lw1414/LoRa---IOT/SX1262 Reference FIles/SX1262MB2CAS_915MHz_e499v01b_prod_folder/SX1262MB2CAS_915MHz_e499v01b_BOM.xlsx

Sheet: SX1262MB2CAS
 |  |  | SX1262MB2CAS mbed shield - 4-Layers 915MHz BOM |  |  | BOM # V1a
 |  |  |  |  |  | SCH # e499v01b
 |  |  | 2019-05-21 | EMr | Version e499v01b | PCB # e499v01b
RefDes | MPN | Geom | Value | Qty | Description | Manufacturer
U1 | SX1262IMLTRT | VQFN24 4x4mm | SX1262 | 1 | 150MHz to 960MHz Low Power Long Range Transceiver | Semtech
U2 | PE4259 | SC70-6 | PE4259 | 1 | SPDT High Power UltraCMOS 10 MHz - 3.0 GHz RF Switch | Peregrine
Resistors
R1 | CRCW06030000Z0EAHP | 0603 | 0R | 1 | Thick Film Resistor ±1%, 1/4W | Vishay/Dale
R2 | CRCW06030000Z0EAHP | 0603 | 0R | 1 | Thick Film Resistor ±1%, 1/4W | Vishay/Dale
R3 | CRCW0402100RFKED | 0402 | 100R | 1 | Thick Film Resistor ±1%, 1/16W | Vishay/Dale
R4 | CRCW0402100RFKED | 0402 | 100R | 1 | Thick Film Resistor ±1%, 1/16W | Vishay/Dale
R5 | CRCW04023K30JNED | 0402 | 3.3k | 1 | Thick Film Resistor ±1%, 1/16W | Vishay/Dale
R6 | CRCW04023K30JNED | 0402 | 3.3k | 1 | Thick Film Resistor ±1%, 1/16W | Vishay/Dale
R915 | CRCW04020000Z0ED | 0402 | 0R | 1 | Thick Film Resistor ±1%, 1/16W | Vishay/Dale
SX1262 | CRCW040210K0FKED | 0402 | 10k | 1 | Thick Film Resistor ±1%, 1/16W | Vishay/Dale
FR1 | CRCW040210K0FKED | 0402 | 10k | 1 | Thick Film Resistor ±1%, 1/16W | Vishay/Dale
XTAL | CRCW04020000Z0ED | 0402 | 0R | 1 | Thick Film Resistor ±1%, 1/16W | Vishay/Dale
Capacitors
C1 | GRM155R71C473KA01J | 0402 | 47nF | 1 | Multilayer ceramic capacitors X7R ±1%, 16V | Murata
C2 | GRM1555C1H470JZ01D | 0402 | 47pF | 1 | Multilayer ceramic capacitors C0G ±5%, 50V | Murata
C4 | GRM1555C1H3R0BA01D | 0402 | 3.0pF | 1 | Multilayer ceramic capacitors C0G ±0.1pF, 50V | Murata
C5 | GRM1555C1H5R6CA01D | 0402 | 5.6pF | 1 | Multilayer ceramic capacitors C0G ±0.25pF, 50V | Murata
C6 | GRM1555C1H390JA01D | 0402 | 39pF | 1 | Multilayer ceramic capacitors C0G ±5%, 50V | Murata
C7 | GRM1555C1H1R8BA01D | 0402 | 1.8pF | 1 | Multilayer ceramic capacitors C0G ±0.1pF, 50V | Murata
C8 | GRM1555C1H390JA01D | 0402 | 39pF | 1 | Multilayer ceramic capacitors C0G ±5%, 50V | Murata
C9 | GRM1555C1H3R3BA01D | 0402 | 3.3pF | 1 | Multilayer ceramic capacitors C0G ±0.1pF, 50V | Murata
C10 | GRM1555C1H3R3BA01D | 0402 | 3.3pF | 1 | Multilayer ceramic capacitors C0G ±0.1pF, 50V | Murata
C11 | GRM1555C1H2R4BA01D | 0402 | 2.4pF | 1 | Multilayer ceramic capacitors C0G ±0.1pF, 50V | Murata
C12 | GRM1555C1H1R8BA01D | 0402 | 1.8pF | 1 | Multilayer ceramic capacitors C0G ±0.1pF, 50V | Murata
C14 | GRM155R61A102KA01D | 0402 | 1nF | 1 | Multilayer ceramic capacitors X5R ±10%, 10V | Murata
C15 | GRM155R61A102KA01D | 0402 | 1nF | 1 | Multilayer ceramic capacitors X5R ±10%, 10V | Murata
C16 | GRM155R61E105KA12D | 0402 | 1uF | 1 | Multilayer ceramic capacitors X5R ±10%, 10V | Murata
C17 | GRM155R61A474KE15D | 0402 | 470nF | 1 | Multilayer ceramic capacitors X5R ±10%, 10V | Murata
C18 | GRM155R71C104KA88D | 0402 | 100nF | 1 | Multilayer ceramic capacitors X7R ±10%, 16V | Murata
C20 | GRM188R61A105KA61D | 0603 | 1uF | 1 | Multilayer ceramic capacitors X5R ±10%, 10V | Murata
C21 | GRM188R61A105KA61D | 0603 | 1uF | 1 | Multilayer ceramic capacitors X5R ±10%, 10V | Murata
C22 | GRM21BR61C106KE15K | 0805 | 10uF | 1 | Multilayer ceramic capacitors X5R ±10%, 16V | Murata
C23 | GRM155R71C104KA88D | 0402 | 100nF | 1 | Multilayer ceramic capacitors X7R ±10%, 16V | Murata
Inductors & Ferrites
L1 | LQW15AN47NJ00D | 0402 | 47nH | 1 | Wirewound Inductor ±5% | Murata
L2 | CRCW04020000Z0ED | 0402 | 0R | 1 | Thick Film Resistor ±1%, 1/16W | Vishay/Dale
L3 | LQW15AN2N5C00D | 0402 | 2.5nH | 1 | Wirewound Inductor ±0.2nH | Murata
L4 | LQW15AN4N7C00D | 0402 | 4.7nH | 1 | Wirewound Inductor ±0.2nH | Murata
L5 | LQW15AN9N1H00D | 0402 | 9.1nH | 1 | Wirewound Inductor ±3% | Murata
L6 | LQW15AN15NH00D | 0402 | 15nH | 1 | Wirewound Inductor ±3% | Murata
L7 | MLZ2012M150W | 0805 | 15uH | 1 | MLZ2012 Multilayer Shielded Inductor ±5% | TDK
Crystal & TCXO
Q1 | EXS00A-CS06465 | NX2016SA 2.0x1.6mm | 32.000MHz | 1 | Crystal unit NDK; Tol. ±10ppm, Cload=10pF, G-Senstivity=2ppb/G max | NDK
or | FTR5123-A0 | QESM09 2.0x1.6mm | 32.000MHz | - | Crystal unit Rakon; Tol. ±10ppm, Cload=10pF, G-Senstivity=2ppb/G max | Rakon
Connectors and others (or P/N equivalent)
ANT | 142-0701-841 | SMA End Launch | 50 Ohms | 1 | SMA End launch jack receptacle for PCB mount | Cinch Connectivity Sol Johnson
J1 | 68000-108HLF | Header 1x8 | 8 pins | 1 | 8 Pins - Through hole single row male connector, Bottom side | FCI
J2 | 68000-110HLF | Header 1x10 | 10 pins | 1 | 10 Pins - Through hole single row male connector, Bottom side | FCI
J3 | 68000-108HLF | Header 1x8 | 8 pins | 1 | 8 Pins - Through hole single row male connector, Bottom side | FCI
J4 | 68000-106HLF | Header 1x6 | 6 pins | 1 | 6 Pins - Through hole single row male connector, Bottom side | FCI
ANA_A5_A6 | 1125S-4P | 4-pin - Grove | 4 pins | 0 | 2mm pitch - Grove universal 4-pin connector for sensor (SKU: 320110033), Top side | Shenzhen NS-Tech
DIO_D9_D10 | 1125S-4P | 4-pin - Grove | 4 pins | 0 | 2mm pitch - Grove universal 4-pin connector for sensor (SKU: 320110033), Top side | Shenzhen NS-Tech
I2C | 1125S-4P | 4-pin - Grove | 4 pins | 0 | 2mm pitch - Grove universal 4-pin connector for sensor (SKU: 320110033), Top side | Shenzhen NS-Tech
Additional or optional components
- | BMI-S-209-F | Shield | - | 0 | Standard Surface Mount Shield in two parts with BMI-S-209-C cover (optional) | Laird Technologies
Remark: components not listed in the BOM or 0 quantity, are not populated on the module.

Sheet: Release
 |  | SX1262MB2CAS mbed shield - 2-Layers 915MHz BOM |  |  |  | BOM # V1a
 |  |  |  |  |  | SCH # e499v01b
 |  | 2019-05-21 | Emr | Version e499v01b |  | PCB # e499v01b
Release histroy
Version | Change notes |  |  |  | By
pcb_e499v01a | Mbed shield based on pcb_e428v03a Reference design - 915MHz version |  |  |  | EMr
pcb_e499v01b | Modified SMA Ground plane new ANT connector and cosmetic |  |  |  | EMr
 | Updated obsolete P/N for large capacitor values (>1.0uF) |  |  |  | EMr
