lw1414/LoRa---IOT/SX1262 Reference FIles/SX1262MB2CAS_915MHz_e499v01b_prod_folder/SX1262MB2xAS_e499v01b_sch_layout.pdf

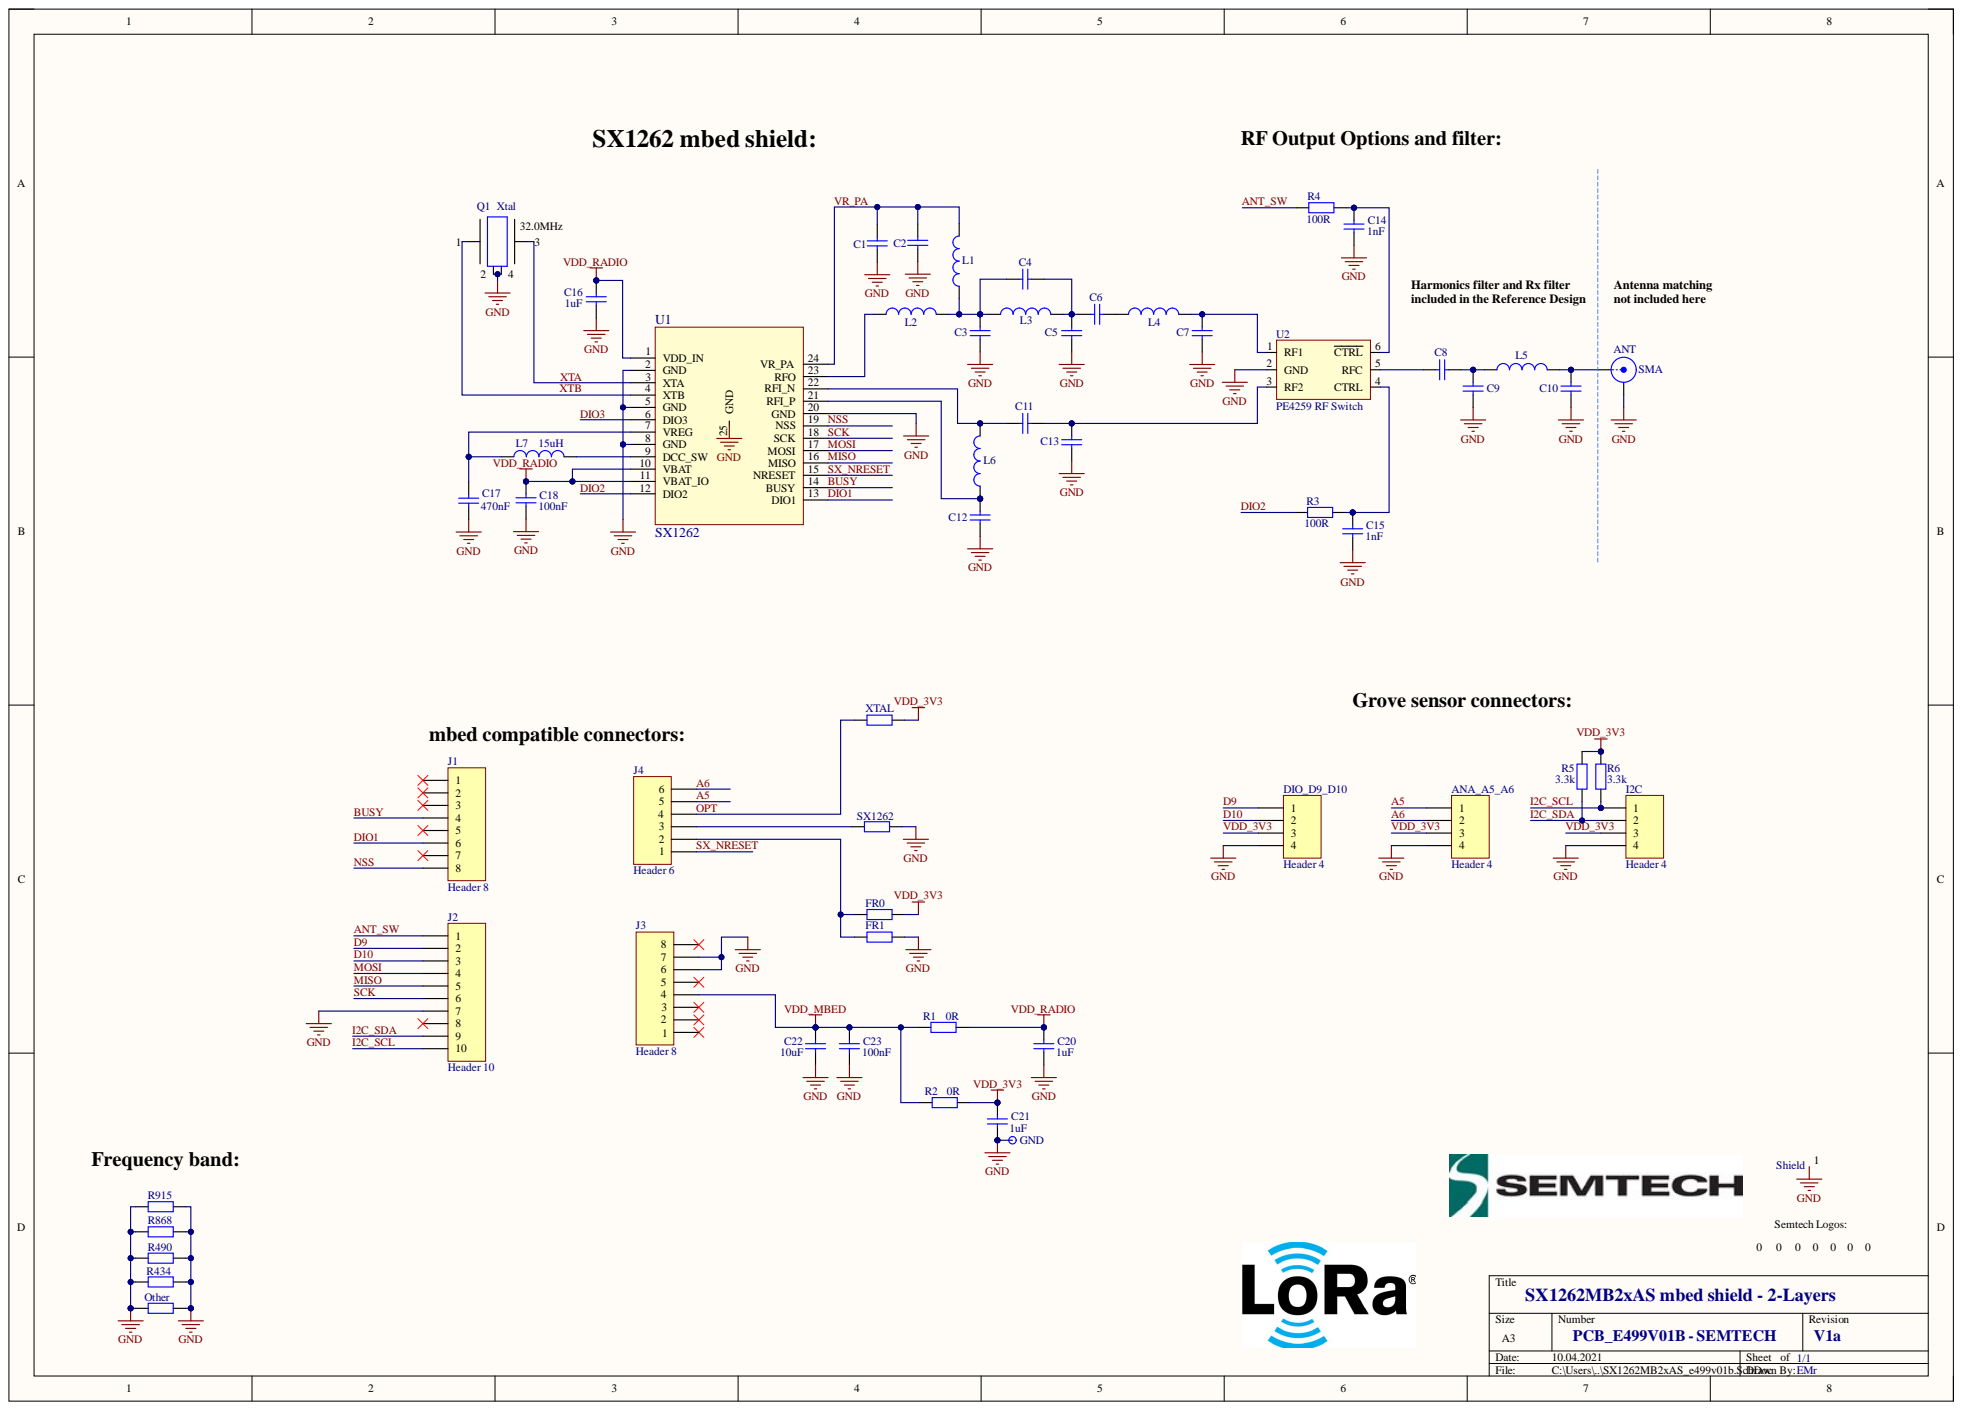
[picture p1: page 1]

RF Output Options and filter:

Harmonics filter and Rx filter
included in the Reference Design

DCC_SW 9 GND | MOSI GND MISO

VDD_RADIO | VBAT 10 | SX_NRESET

VBAT_IO 11 | BUSY

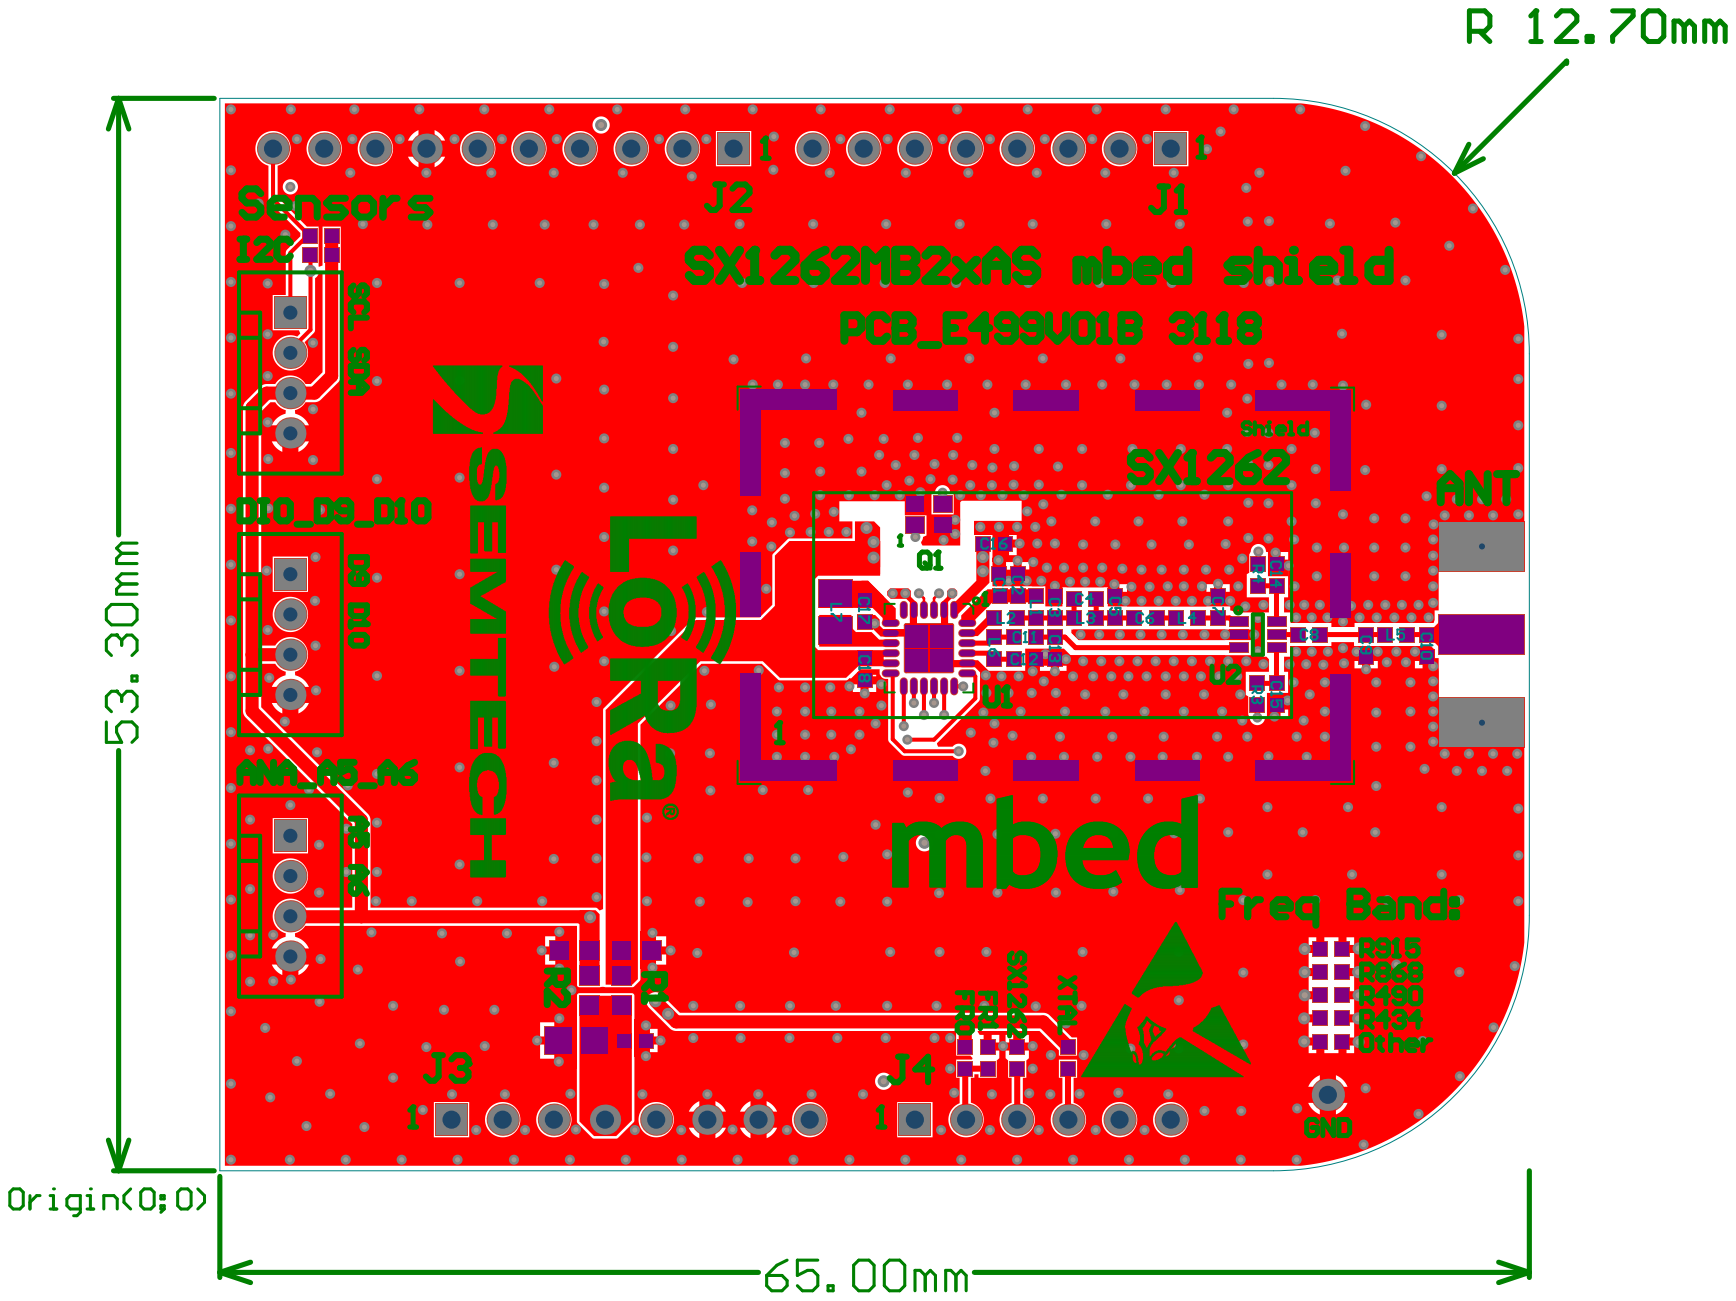
[picture p2: page 2]

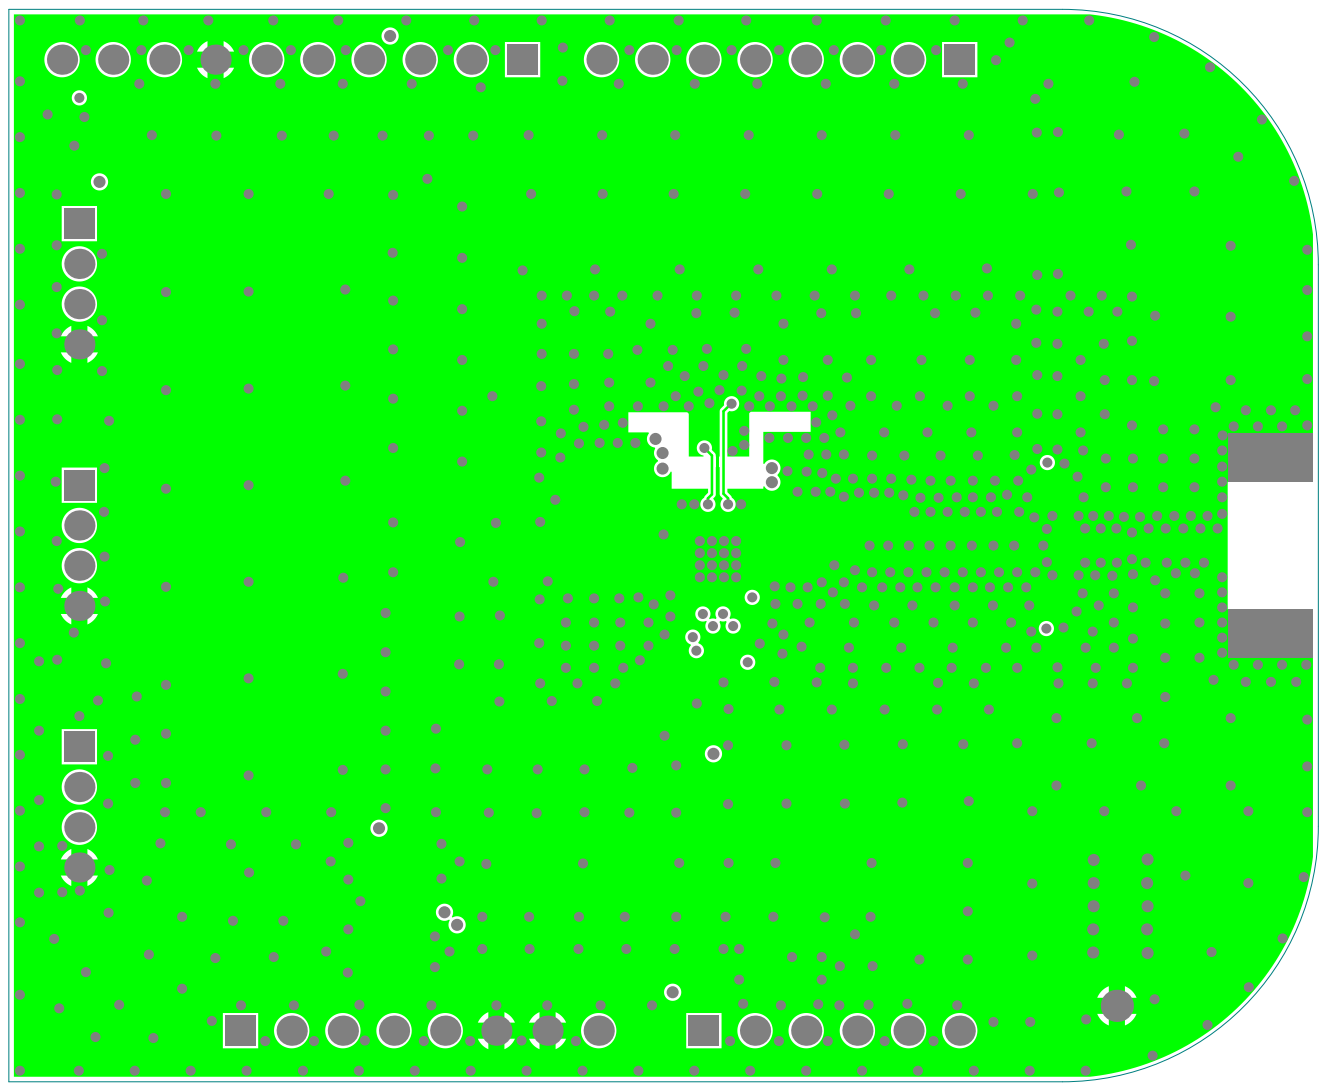
[picture p3: page 3]

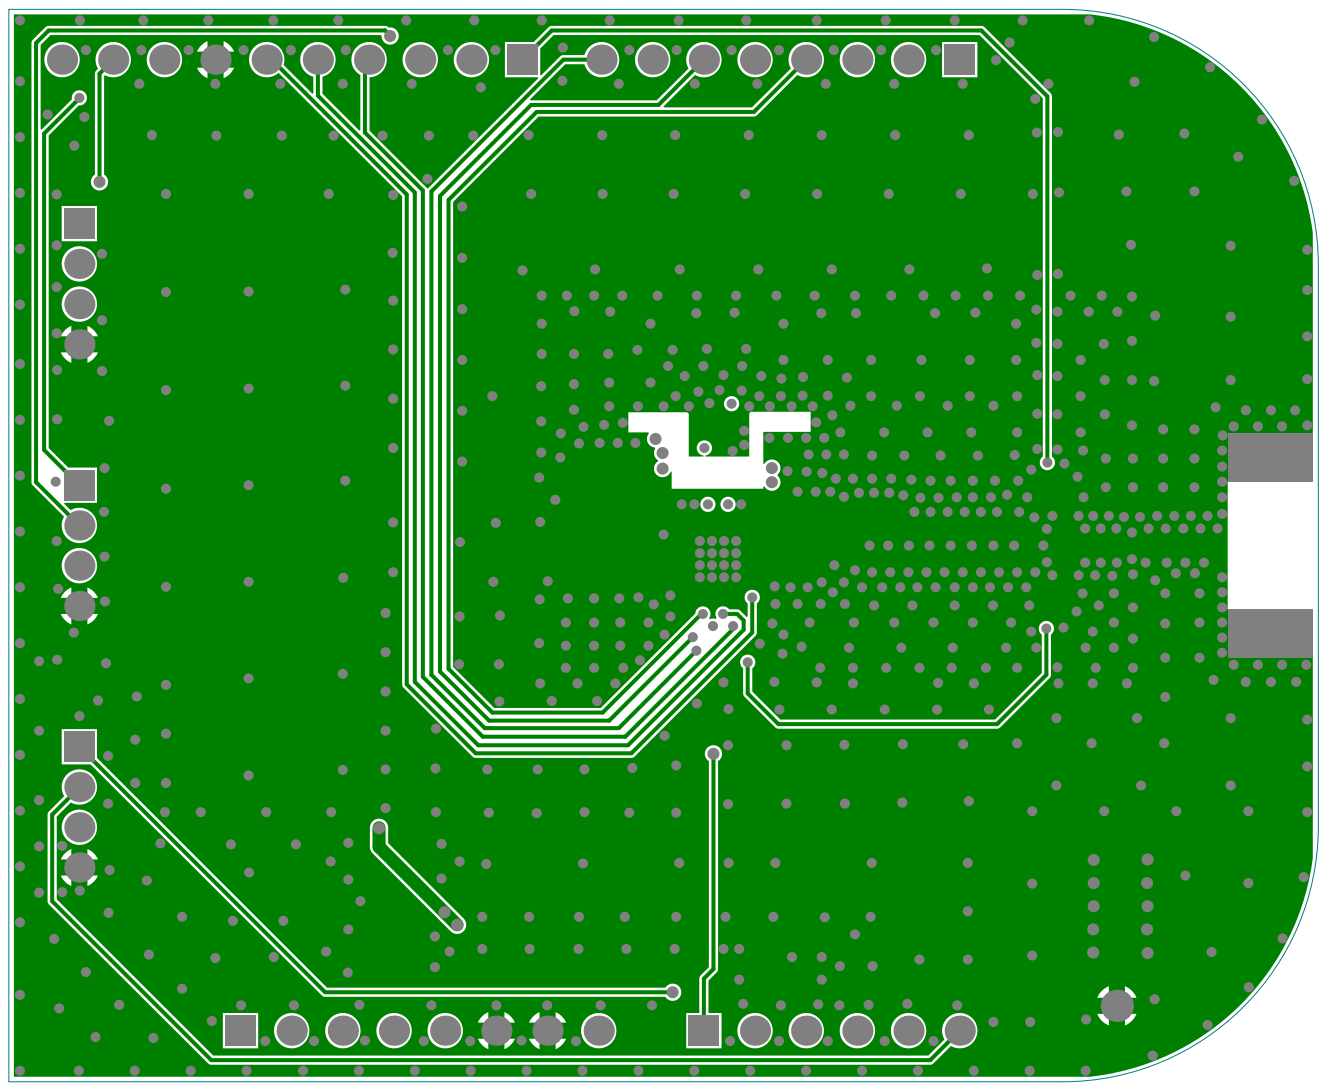
[picture p4: page 4]

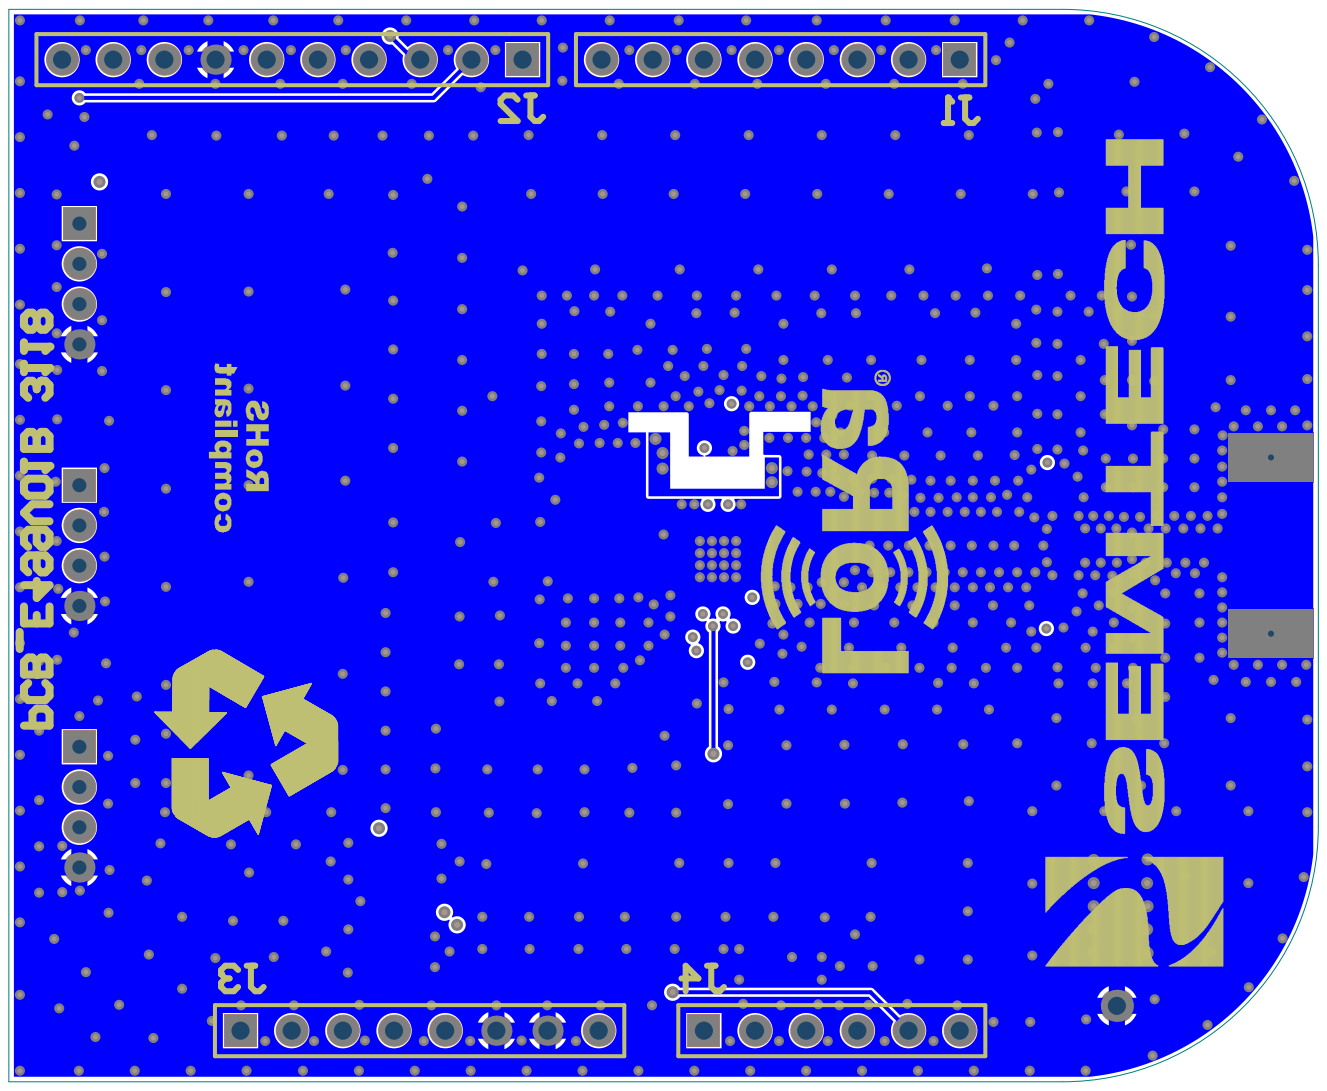
[picture p5: page 5]
