lw1414/LoRa---IOT/(list of files, drawings)

Other design files:
SX1262 Reference FIles/SX1262MB2xAS_e499v01b_PCB_Altium_Package/SX1262MB2xAS_e499v01b.PcbDoc
SX1262 Reference FIles/SX1262MB2xAS_e499v01b_PCB_Altium_Package/SX1262MB2xAS_e499v01b.PcbLib
SX1262 Reference FIles/SX1262MB2xAS_e499v01b_PCB_Altium_Package/SX1262MB2xAS_e499v01b.PrjPCB
SX1262 Reference FIles/SX1262MB2xAS_e499v01b_PCB_Altium_Package/SX1262MB2xAS_e499v01b.SchDoc
SX1262 Reference FIles/SX1262MB2xAS_e499v01b_PCB_Altium_Package/SX1262MB2xAS_e499v01b.SchLib
