lw1414/LoRa---IOT/SX1262_LoRa_Module/SX1262_LoRa_Module.kicad_pcb

## KiCad design SX1262_LoRa_Module/SX1262_LoRa_Module.kicad_pcb (2026-10-25)

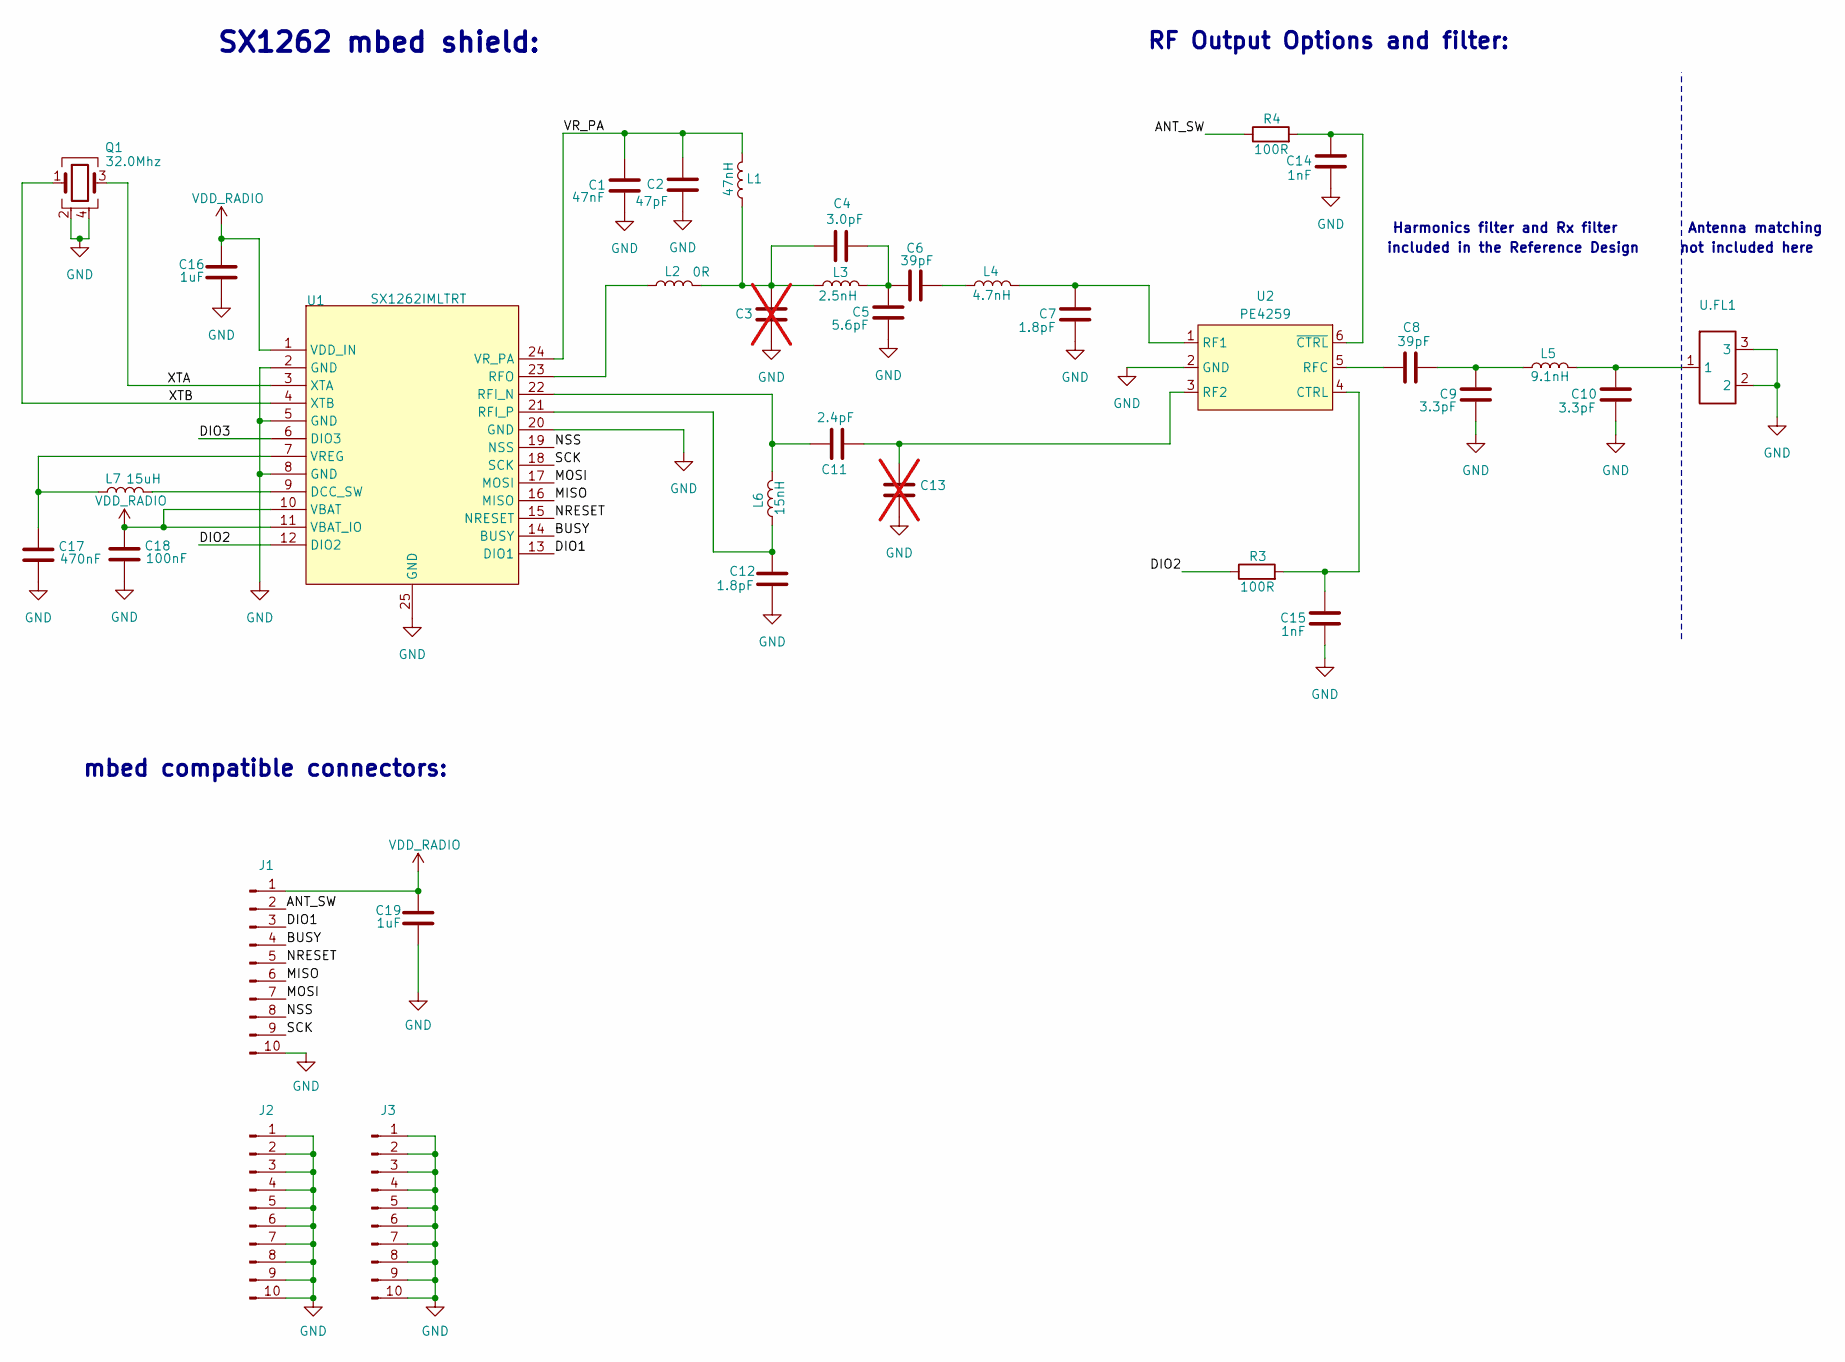
[picture p6: schematic SX1262_LoRa_Module.kicad_sch]

Parts:
C1: 47nF; C_0402_1005Metric; LCSC C307434
C2: 47pF; C_0402_1005Metric; LCSC C76970
C3, C13: C_0402_1005Metric; not fitted
C4: 3.0pF; C_0402_1005Metric; LCSC C88891
C5: 5.6pF; C_0402_1005Metric; LCSC C161329
C6, C8: 39pF; C_0402_1005Metric; LCSC C1563
C7, C12: 1.8pF; C_0402_1005Metric; LCSC C1553
C9, C10: 3.3pF; C_0402_1005Metric; LCSC C76906
C11: 2.4pF; C_0402_1005Metric; LCSC C48346
C14, C15: 1nF; C_0402_1005Metric; LCSC C189467
C16: 1uF; C_0402_1005Metric; LCSC C14445
C17: 470nF; C_0402_1005Metric; LCSC C92361
C18: 100nF; C_0402_1005Metric; LCSC C1525
C19: 1uF; C_0603_1608Metric; LCSC C53282223
J1, J2, J3: Conn_01x10_Pin; PinHeader_1x10_P2.54mm_Vertical
L1: 47nH; L_0402_1005Metric; LCSC C192855
L2: 0R; L_0402_1005Metric; LCSC C106231
L3: 2.5nH; L_0402_1005Metric; LCSC C703121
L4: 4.7nH; L_0402_1005Metric; LCSC C98064
L5: 9.1nH; L_0402_1005Metric; LCSC C6652904
L6: 15nH; L_0402_1005Metric; LCSC C91621
L7: 15uH; L0805; LCSC C383402
Q1: 32.0Mhz; CRYSTAL-SMD_4P-L2.0-W1.6-BL; LCSC C1986260
R3, R4: 100R; R_0402_1005Metric; LCSC C106232
U1: SX1262IMLTRT; QFN-24_L4.0-W4.0-P0.50-BL-EP2.6; LCSC C191341
U2: PE4259; SC-70-6_L2.2-W1.3-P0.65-LS2.1-BL; LCSC C470892
U.FL1: IPEX-SMD_3P-L2.6-W2.6-LS3.0; LCSC C22418213

Connections:
/ANT_SW: J1.2, R4.1
/BUSY: J1.4, U1.14 (BUSY)
/DIO1: J1.3, U1.13 (DIO1)
/DIO2: R3.1, U1.12 (DIO2)
/DIO3: U1.6 (DIO3)
/MISO: J1.6, U1.16 (MISO)
/MOSI: J1.7, U1.17 (MOSI)
/NRESET: J1.5, U1.15 (NRESET)
/NSS: J1.8, U1.19 (NSS)
/SCK: J1.9, U1.18 (SCK)
/VR_PA: C1.2, C2.2, L1.2, U1.24 (VR_PA)
/XTA: Q1.3, U1.3 (XTA)
/XTB: Q1.1, U1.4 (XTB)
GND: C1.1, C2.1, C3.1, C5.1, C7.1, C9.1, C10.1, C12.2, C13.1, C14.1, C15.1, C16.2, C17.2, C18.2, C19.2, J1.10, J2.1, J2.2, J2.3, J2.4, J2.5, J2.6, J2.7, J2.8, J2.9, J2.10, J3.1, J3.2, J3.3, J3.4, J3.5, J3.6, J3.7, J3.8, J3.9, J3.10, Q1.2, Q1.4, U1.2 (GND), U1.5 (GND), U1.8 (GND), U1.20 (GND), U1.25 (GND), U2.2 (GND), U.FL1.2, U.FL1.3; also elsewhere on the board
unnamed: C3.2, C4.2, L1.1, L2.2, L3.1
unnamed: C4.1, C5.2, C6.2, L3.2
unnamed: C6.1, L4.1
unnamed: C8.1, C9.2, L5.1
unnamed: C10.2, L5.2, U.FL1.1
unnamed: L7.2, U1.9 (DCC_SW)
unnamed: C11.1, L6.2, U1.22 (RFI_N)
unnamed: C12.1, L6.1, U1.21 (RFI_P)
unnamed: L2.1, U1.23 (RFO)
unnamed: C17.1, L7.1, U1.7 (VREG)
unnamed: C15.2, R3.2, U2.4 (CTRL)
unnamed: C7.2, L4.2, U2.1 (RF1)
unnamed: C11.2, C13.2, U2.3 (RF2)
unnamed: C8.2, U2.5 (RFC)
unnamed: C14.2, R4.2, U2.6 (~CTRL)
VDD_RADIO: C16.1, C18.1, C19.1, J1.1, U1.1 (VDD_IN), U1.10 (VBAT), U1.11 (VBAT_IO)

Notes on the sheet:
Antenna matching
RF Output Options and filter:
included in the Reference Design
Harmonics filter and Rx filter
not included here
SX1262 mbed shield:
mbed compatible connectors:

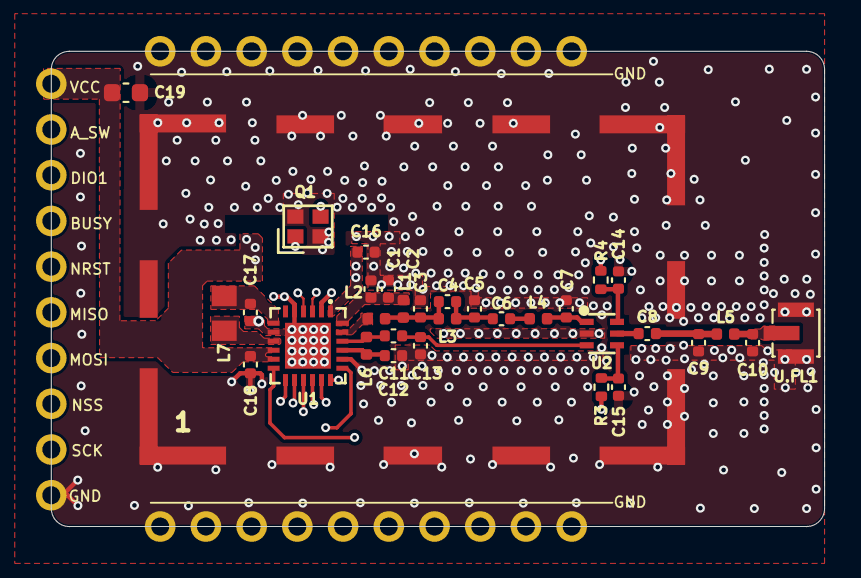
[picture p7: board SX1262_LoRa_Module.kicad_pcb from above]

Board: 4 copper layers, 43.0 x 26.4 mm, 36 parts (0 on the bottom side), 29 nets.

Other parts of the board:
Shield: Logo symbol; BMIS-209-F - Shield

Their connections:
GND: Shield.1; also elsewhere on the board
