lw1414/LoRa---IOT/(commit log)

2026-10-17 -done scheme based on semtech
    - create scheme based on semtech
    - remove grove sensor schematic reference
    - add footprint & lcsc for sx1262,rf switch and u.fl
    [SX1262MB2CAS_915MHz_e499v01b_BOM.xlsx, SX1262MB2xAS_e499v01b.PcbDoc, SX1262MB2xAS_e499v01b.PcbLib, SX1262MB2xAS_e499v01b.PrjPCB, SX1262MB2xAS_e499v01b.SchDoc, SX1262MB2xAS_e499v01b.SchLib, SX1262_LoRa_Module.kicad_pcb, SX1262_LoRa_Module.kicad_sch]
2026-10-19 -added LC value for the filters
    - added values for LC filters based on SEMTECH BOM
    - It is recommended to do an 0402 size for the components for the filters , thus following SEMTECH layout size
    - Need to note that schemetic here doesnt have yet 0402 footprints designation still contemplating
    [SX1262MB2xAS_e499v01b.kicad_sch, SX1262_LoRa_Module.kicad_pcb, SX1262_LoRa_Module.kicad_sch]
2026-10-20 -layout update
    - place footprint per component on schematic
    - placed the components on pcb layout based on the evaluation board
    - included shiled on the pcb placement
    - placed routing on the pcb for the IC and rf switch
    - remaining task to deliberate is 10 pins if its either castillated or header
    [SX1262MB2xAS_e499v01b.kicad_pcb, SX1262_LoRa_Module.kicad_pcb, SX1262_LoRa_Module.kicad_sch]
2026-10-21 -pcb
    -done pcb routing
    -including castellated pads
    -warnings and error is due to tight placement of the components for the filter and tuning
    [SX1262_LoRa_Module.kicad_pcb, SX1262_LoRa_Module.kicad_sch]
2026-10-22 -added side castellation
    -added side castellation
    [SX1262_LoRa_Module.kicad_pcb, SX1262_LoRa_Module.kicad_sch]
2026-10-25 -update bom
    -updated bom based on the evm
    -put booklet list for the inductor
    [Inductor List Booklet Candidates.xlsx, SX1262_LoRa_Module.kicad_pcb, SX1262_LoRa_Module.kicad_sch]
